gonzho000/chpc/docs/as_s1.jpg

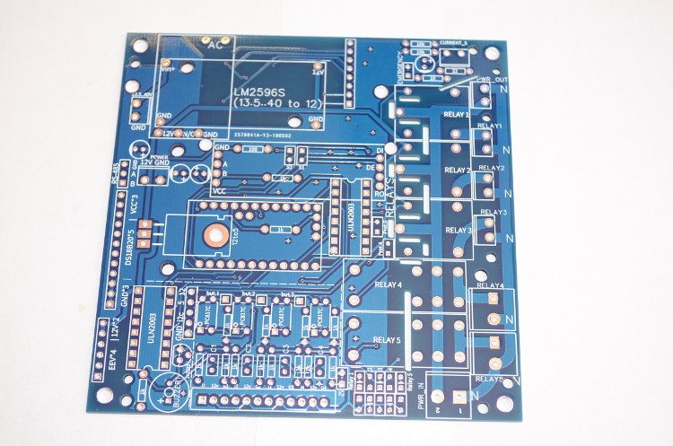
docs/as_s1.jpg
