gonzho000/chpc/docs/as_s2.jpg

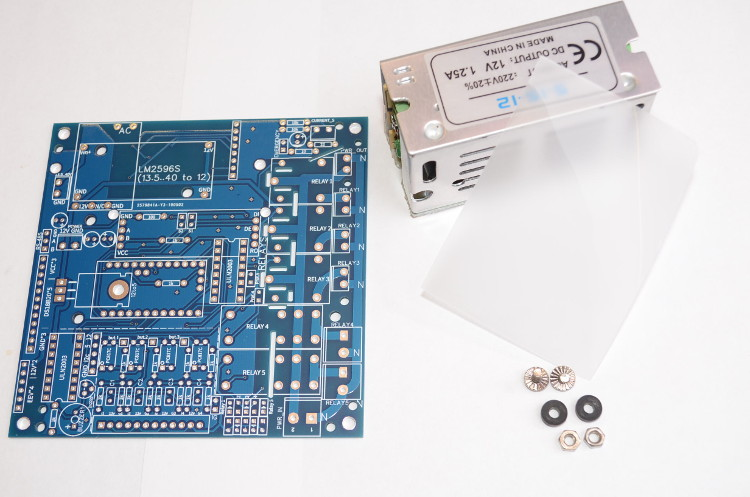
docs/as_s2.jpg
