gonzho000/chpc/docs/as_s3.jpg

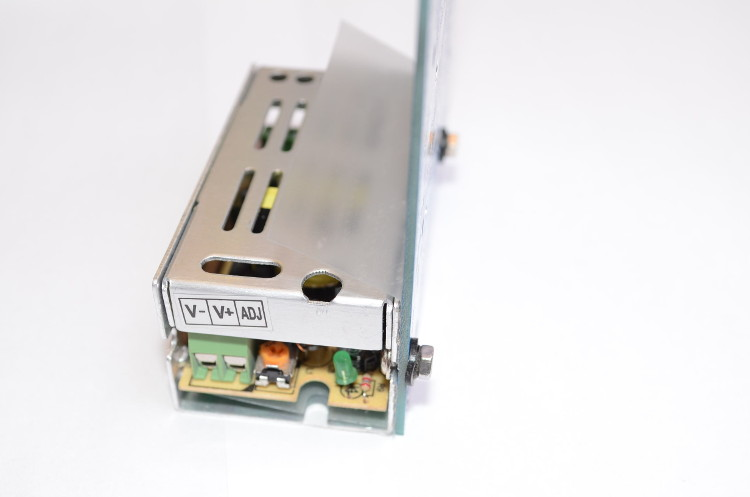
docs/as_s3.jpg
