gonzho000/chpc/docs/as_s4.jpg

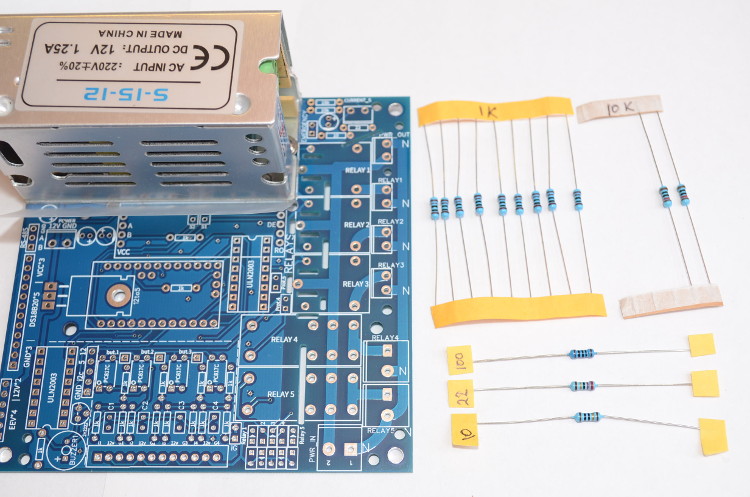
docs/as_s4.jpg
