gonzho000/chpc/docs/as_s5.jpg

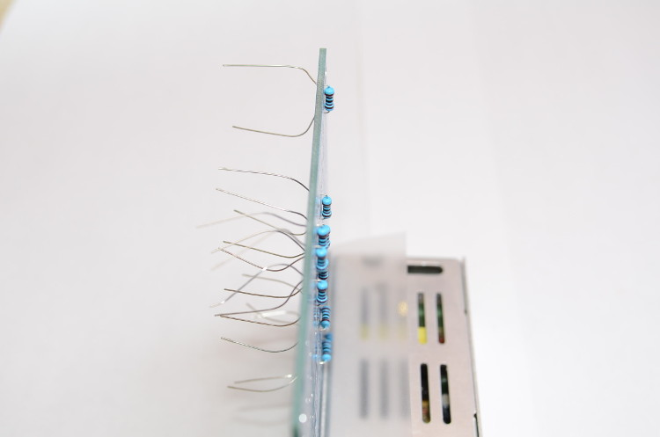
docs/as_s5.jpg
