gonzho000/chpc/docs/as_s6.jpg

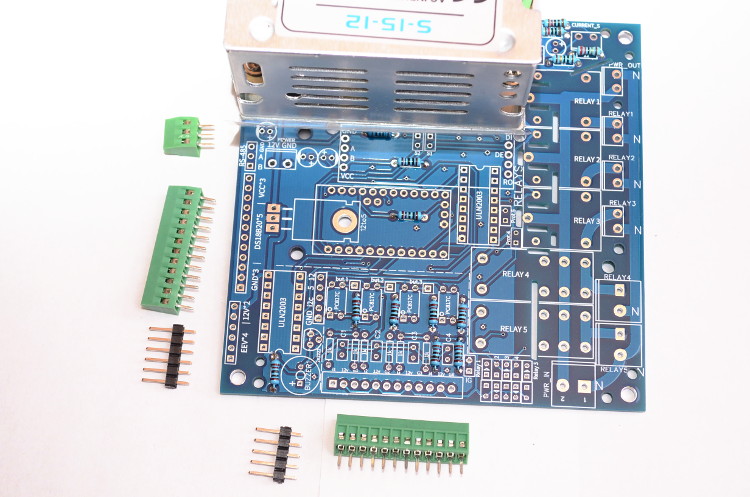
docs/as_s6.jpg
