gonzho000/chpc/docs/as_s7.jpg

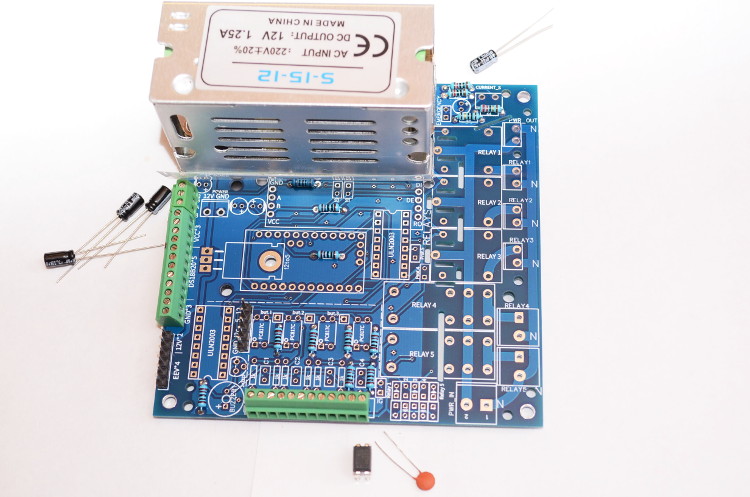
docs/as_s7.jpg
