gonzho000/chpc/docs/as_s8.jpg

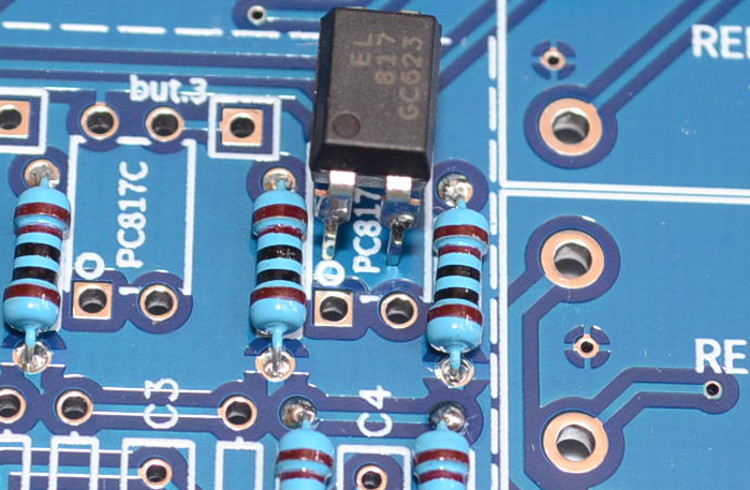
docs/as_s8.jpg
