gonzho000/chpc/docs/as_s9.jpg

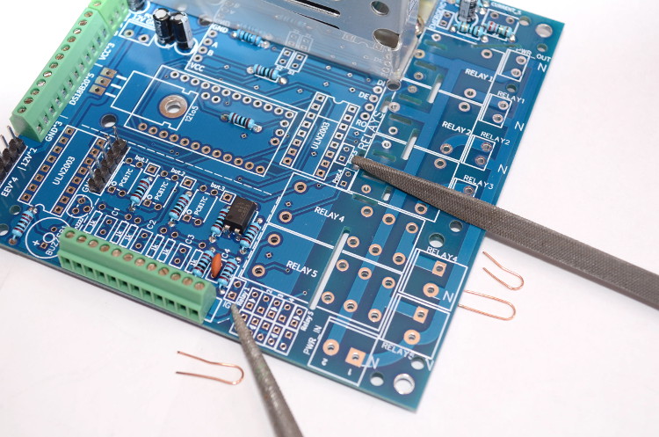
docs/as_s9.jpg
