gonzho000/chpc/docs/as_s10.jpg

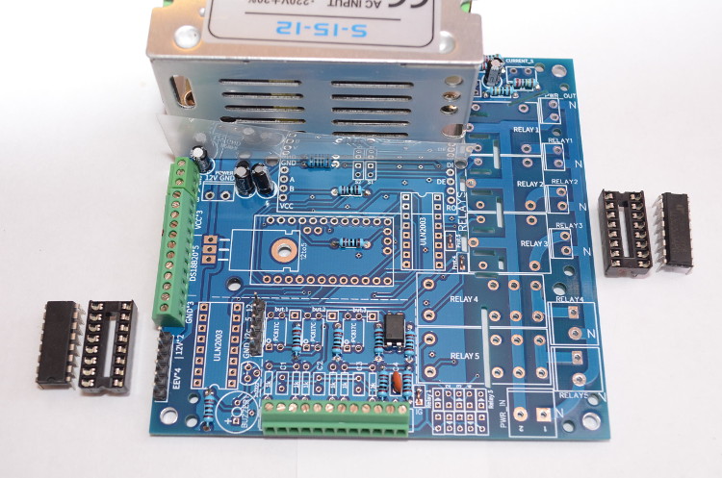
docs/as_s10.jpg
