gonzho000/chpc/docs/as_s11.jpg

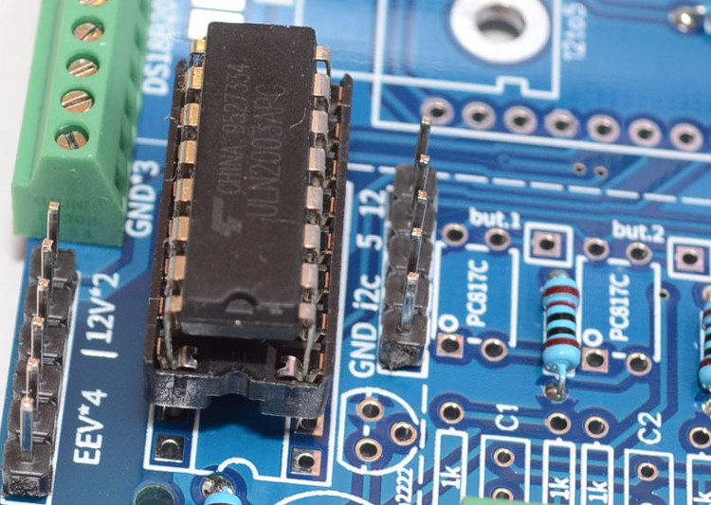
docs/as_s11.jpg
