gonzho000/chpc/docs/as_s12.jpg

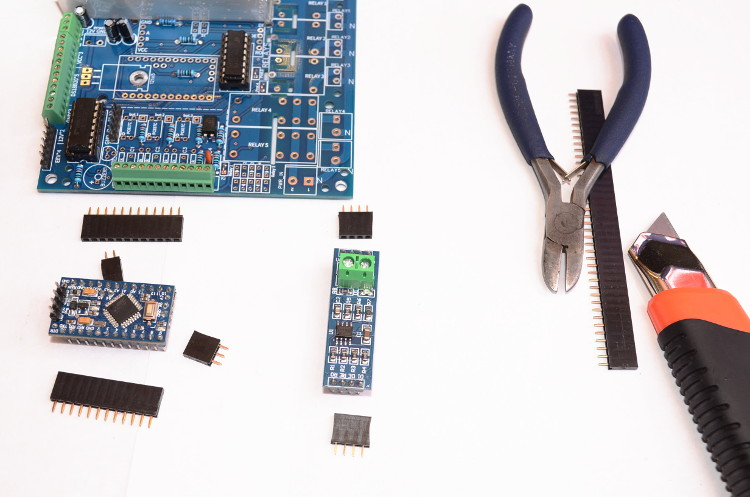
docs/as_s12.jpg
