gonzho000/chpc/docs/as_s13.jpg

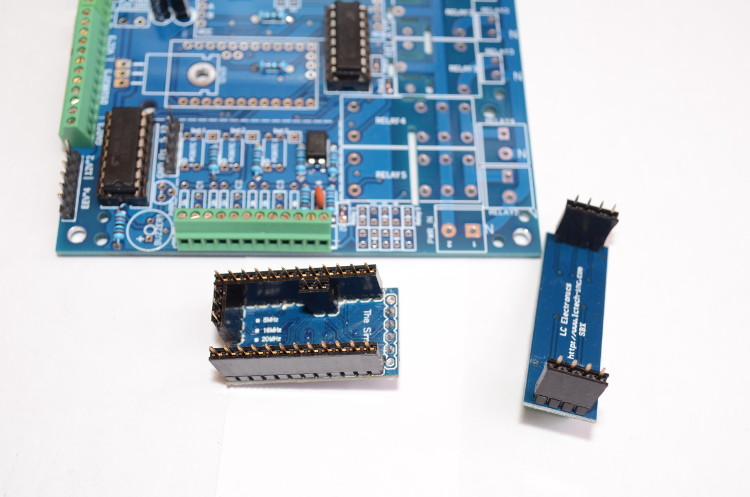
docs/as_s13.jpg
