gonzho000/chpc/docs/as_s14.jpg

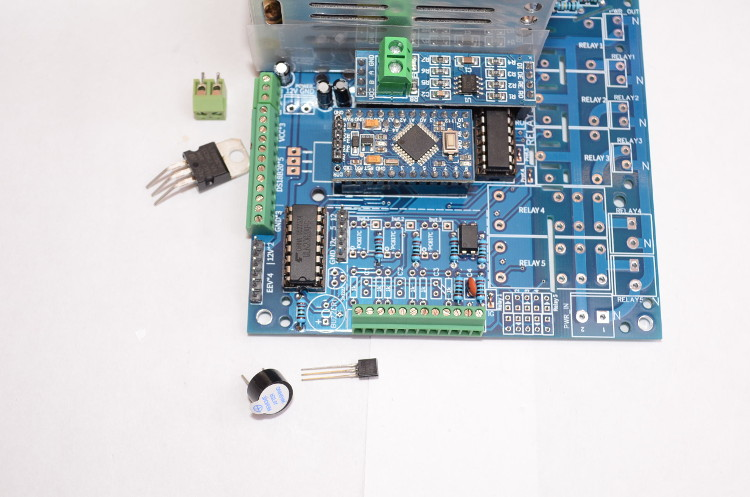
docs/as_s14.jpg
