gonzho000/chpc/docs/as_s15.jpg

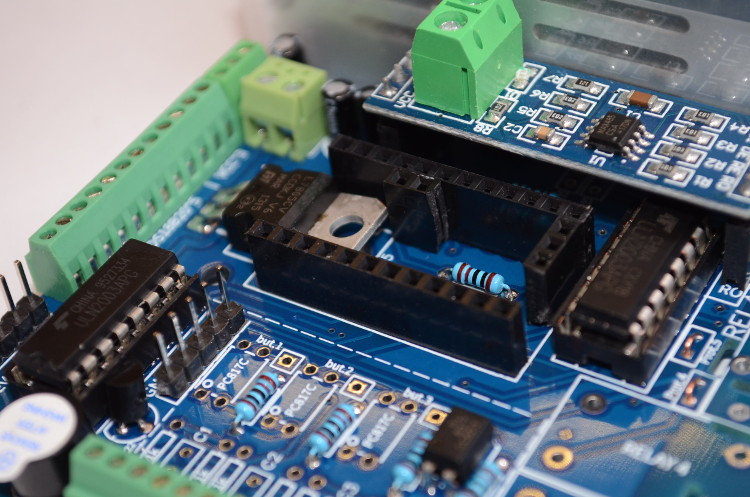
docs/as_s15.jpg
