gonzho000/chpc/docs/as_s16.jpg

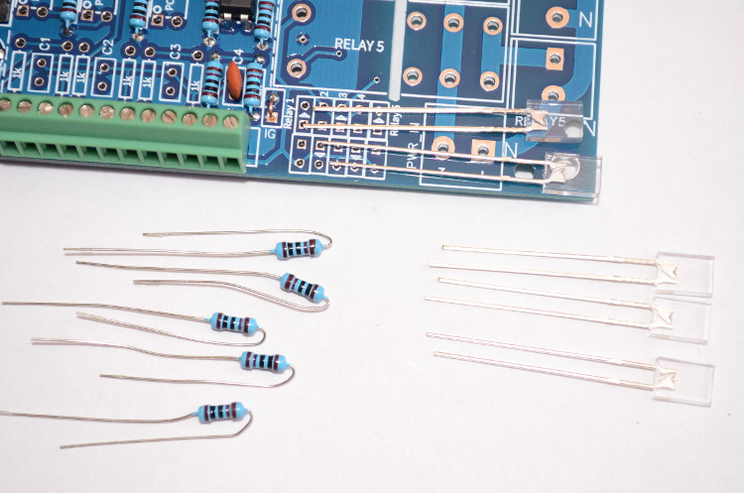
docs/as_s16.jpg
