gonzho000/chpc/docs/as_s17.jpg

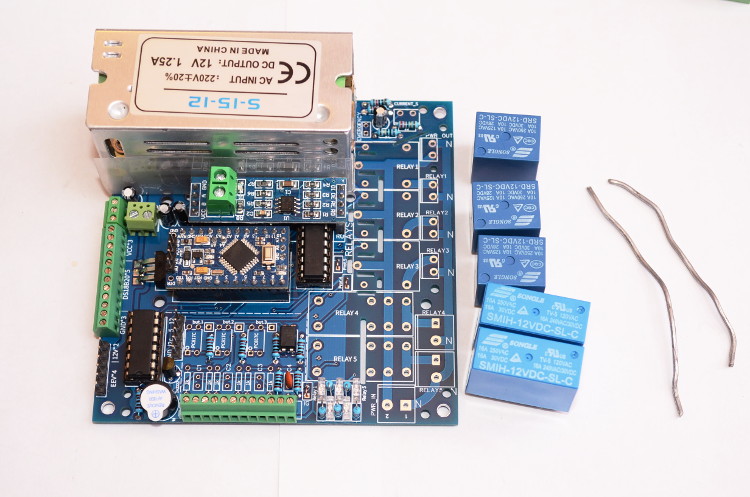
docs/as_s17.jpg
