gonzho000/chpc/docs/as_s18.jpg

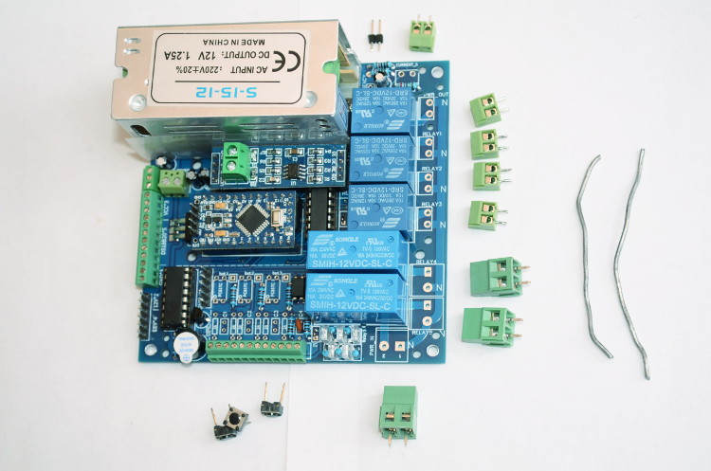
docs/as_s18.jpg
