gonzho000/chpc/docs/as_s19.jpg

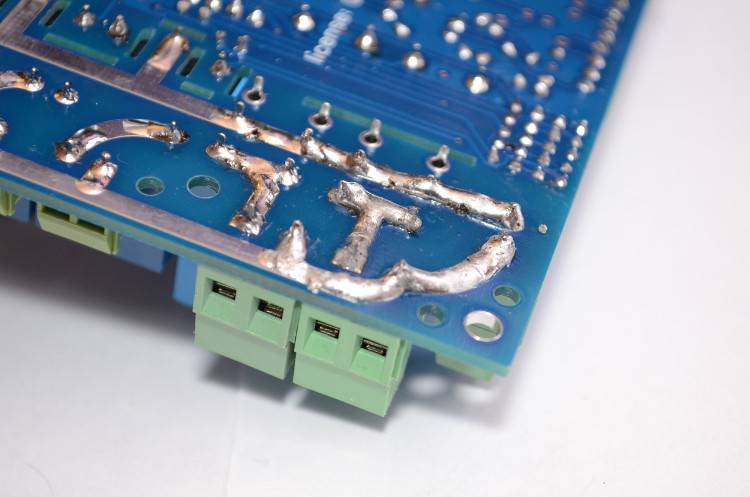
docs/as_s19.jpg
