gonzho000/chpc/docs/as_s20.jpg

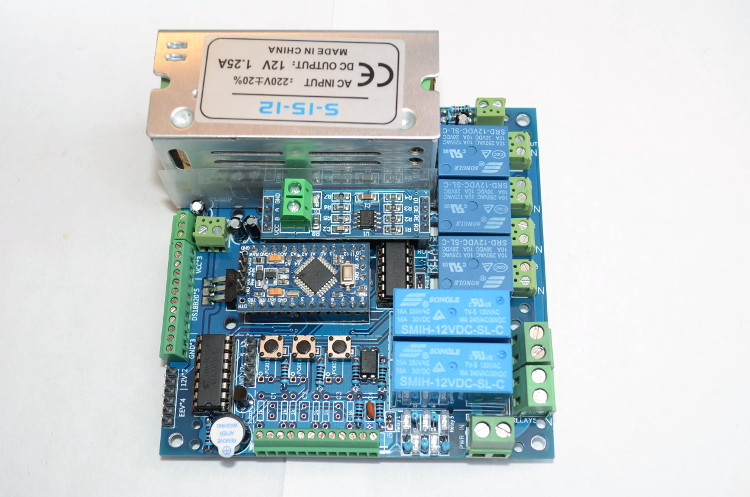
docs/as_s20.jpg
