gonzho000/chpc/docs/as_s21.jpg

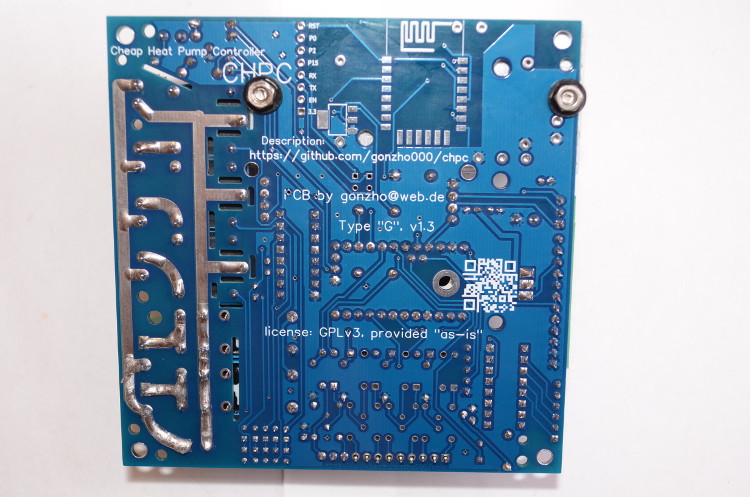
docs/as_s21.jpg
