gonzho000/chpc/docs/as_s22.jpg

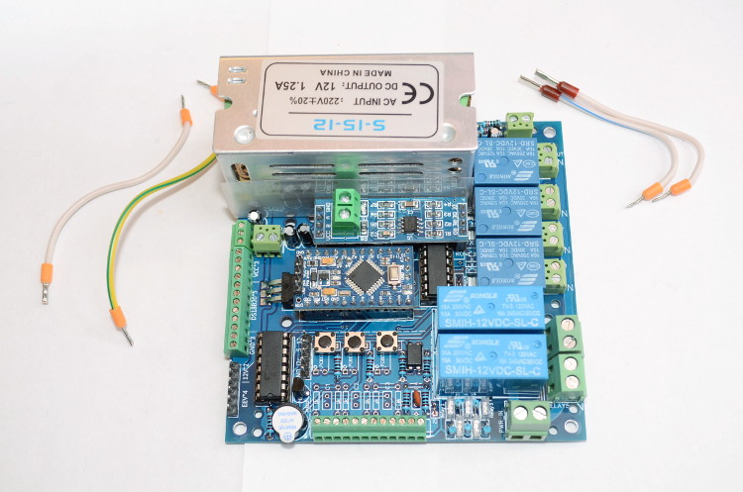
docs/as_s22.jpg
