gonzho000/chpc/docs/as_s23.jpg

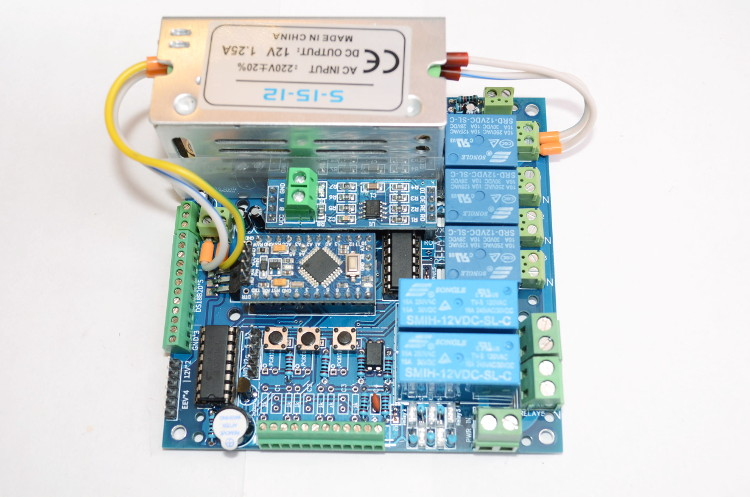
docs/as_s23.jpg
