gonzho000/chpc/docs/as_s24.jpg

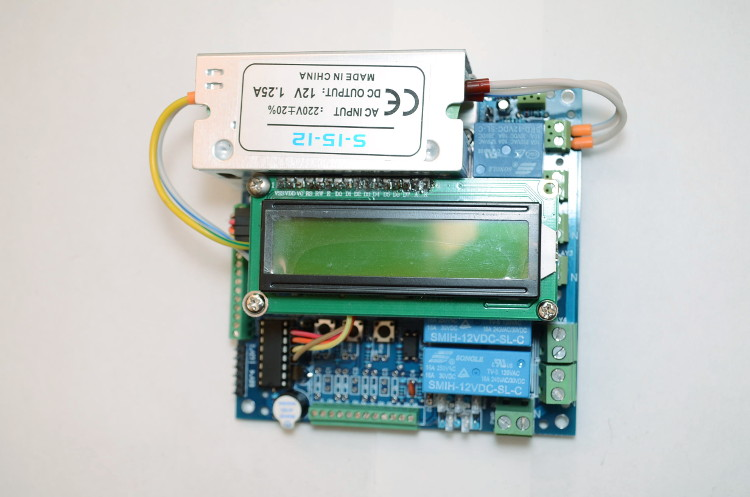
docs/as_s24.jpg
