gonzho000/chpc/m_CHPC_i1.jpg

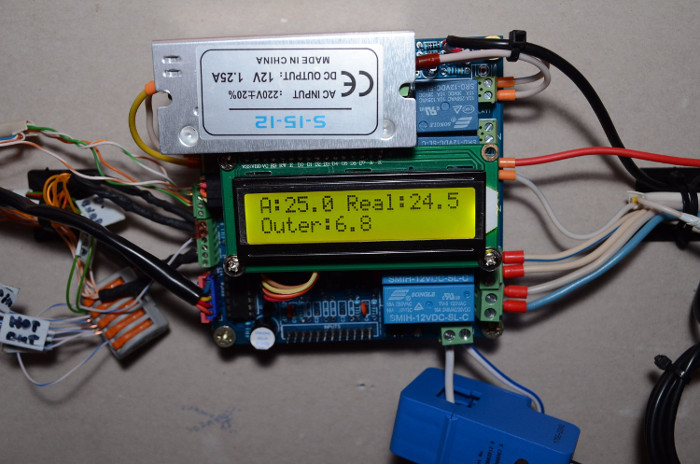
m_CHPC_i1.jpg
