gonzho000/chpc/(threads)

Thread 1 (2020-12-10):

Wow nice project and PCB

ldijkman, 2020-12-10:
Wow nice project and PCB

question
how did you make the foto comeup
when i search on thrmostats
see https://github.com/topics/thermostat

like thermostats
https://github.com/ldijkman/ART-ESP32-Touch-TFT-Thermostat

gonzho000, 2020-12-12:
Thank you,

About your question: do you mean "with what device did you make photos" or "can you attach photos of upcoming external display" or something else?

ldijkman, 2020-12-12:
hi

on the left side of your github page there are tags
if you click on a tag => then you get a topic search

your project showed a nice foto in the topic search
eye catching
liked that and wondered how you did that

but i have found it
i have a foto also in topic search now
https://github.com/topics/diy-nest

Thank you
greet luberth
from the netherlands

gonzho000, 2020-12-12:
oh, i see.

i don't remember how i did it..

Have a good day!

Closed 2020-12-12.
