gonzho000/chpc/CHPC_v1.3_PCB_schematic.pdf

# 1 GND 8 DI 5V

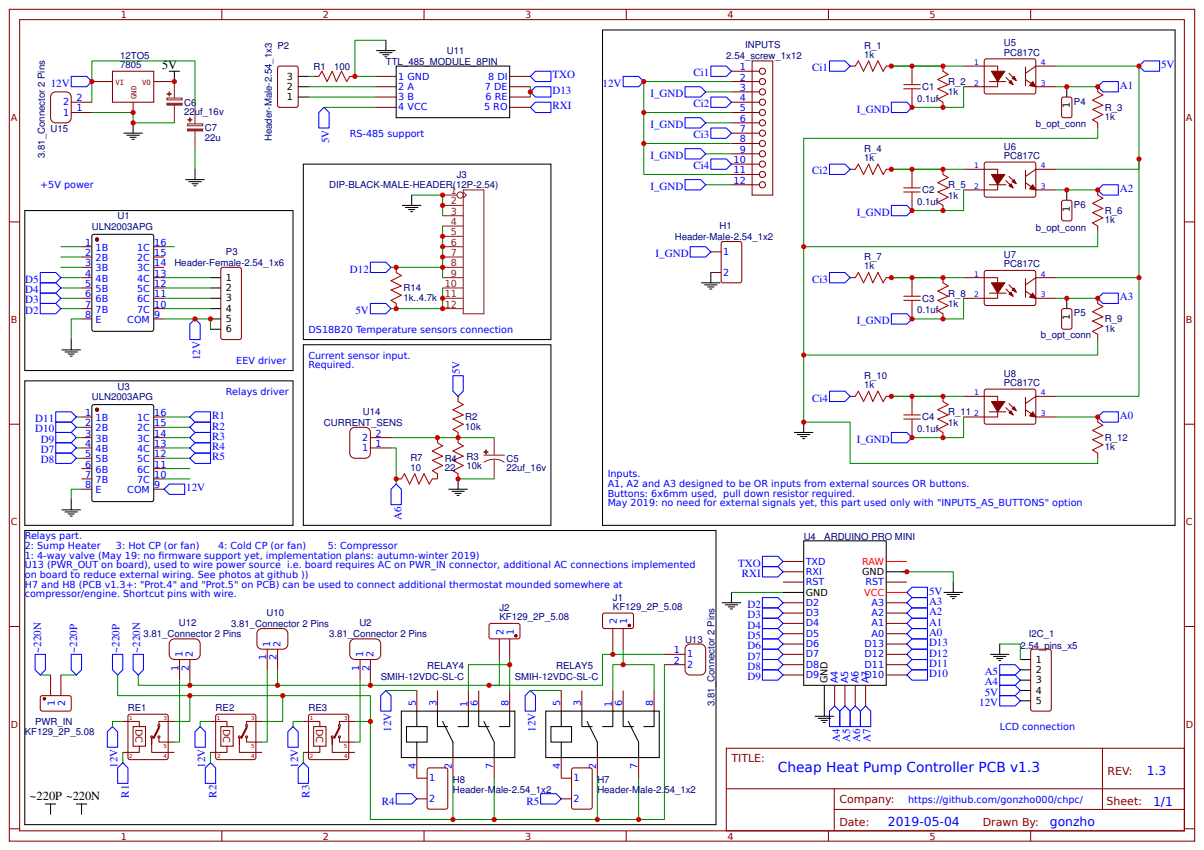
[picture p38: page 1]

DIP-BLACK-MALE-HEADER(12P-2.54)

Inputs.
A1, A2 and A3 designed to be OR inputs from external sources OR buttons.
Buttons: 6x6mm used, pull down resistor required.
May 2019: no need for external signals yet, this part used only with "INPUTS_AS_BUTTONS" option

Relays part.
1: 4-way valve (May 19: no firmware support yet, implementation plans: autumn-winter 2019)
U13 (PWR_OUT on board), used to wire power source i.e. board requires AC on PWR_IN connector, additional AC connections implemented
on board to reduce external wiring. See photos at github ))
H7 and H8 (PCB v1.3+: "Prot.4" and "Prot.5" on PCB) can be used to connect additional thermostat mounded somewhere at
compressor/engine. Shortcut pins with wire.

Company: https://github.com/gonzho000/chpc/

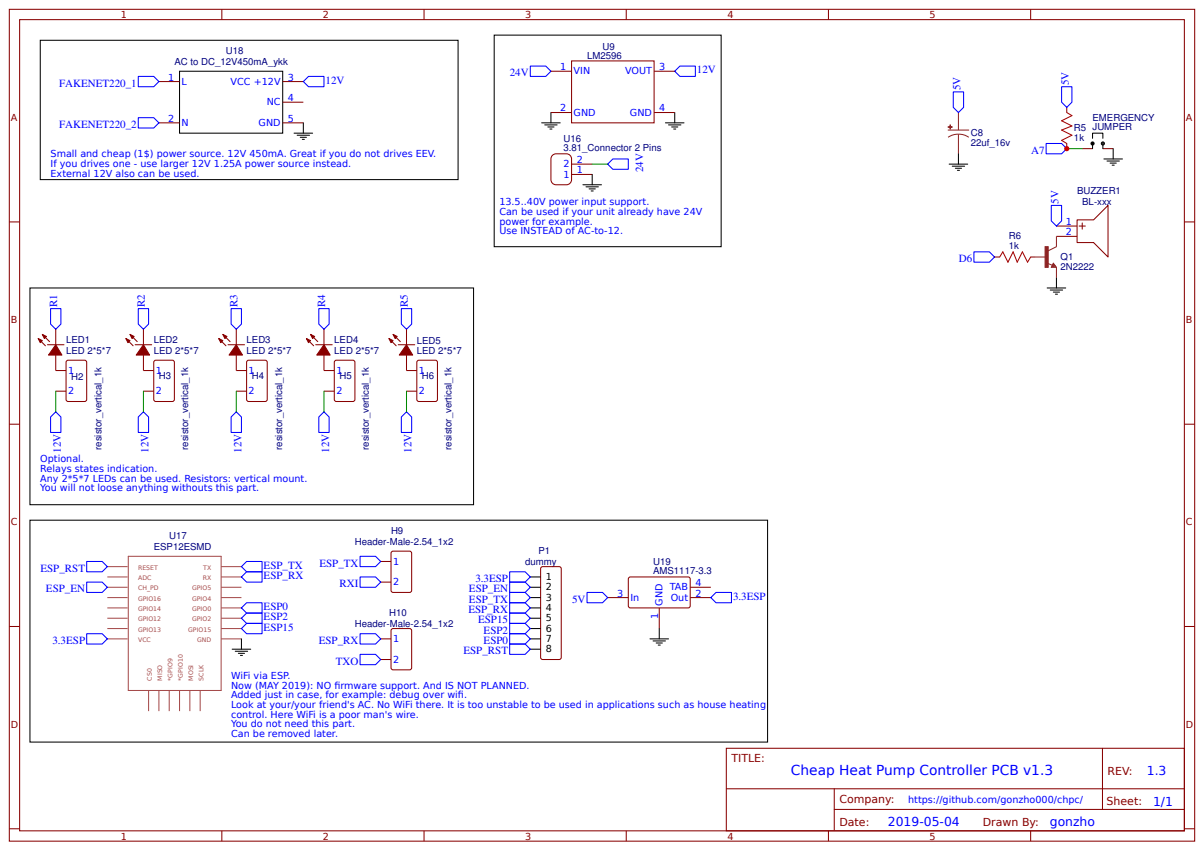
[picture p39: page 2]

Small and cheap (1$) power source. 12V 450mA. Great if you do not drives EEV.
If you drives one - use larger 12V 1.25A power source instead.
External 12V also can be used.

13.5..40V power input support.
Can be used if your unit already have 24V
power for example.
Use INSTEAD of AC-to-12.

Optional.
Relays states indication.
Any 2*5*7 LEDs can be used. Resistors: vertical mount.
You will not loose anything withouts this part.

WiFi via ESP.
Now (MAY 2019): NO firmware support. And IS NOT PLANNED.
Added just in case, for example: debug over wifi. Look at your/your friend's AC. No WiFi there. It is too unstable to be used in applications such as house heating
control. Here WiFi is a poor man's wire.
You do not need this part.
Can be removed later.

Company: https://github.com/gonzho000/chpc/
