gonzho000/chpc/(commit log)

2019-05-02 PCB v1.1, release
2019-05-04 Schematic with few comments
2019-05-05 Upcoming PCB v1.3, !UNTESTED!
2019-05-05 PCB v1.3
2019-05-06 BOM v1.3
2019-05-17 assembly images
